VanceVagell/kv4p-ht/pcb/filter-test-boards/MiniCircuits-LTCC/MiniCircuits-LTCC.kicad_pcb

## KiCad design pcb/filter-test-boards/MiniCircuits-LTCC/MiniCircuits-LTCC.kicad_pcb (2025-03-26)

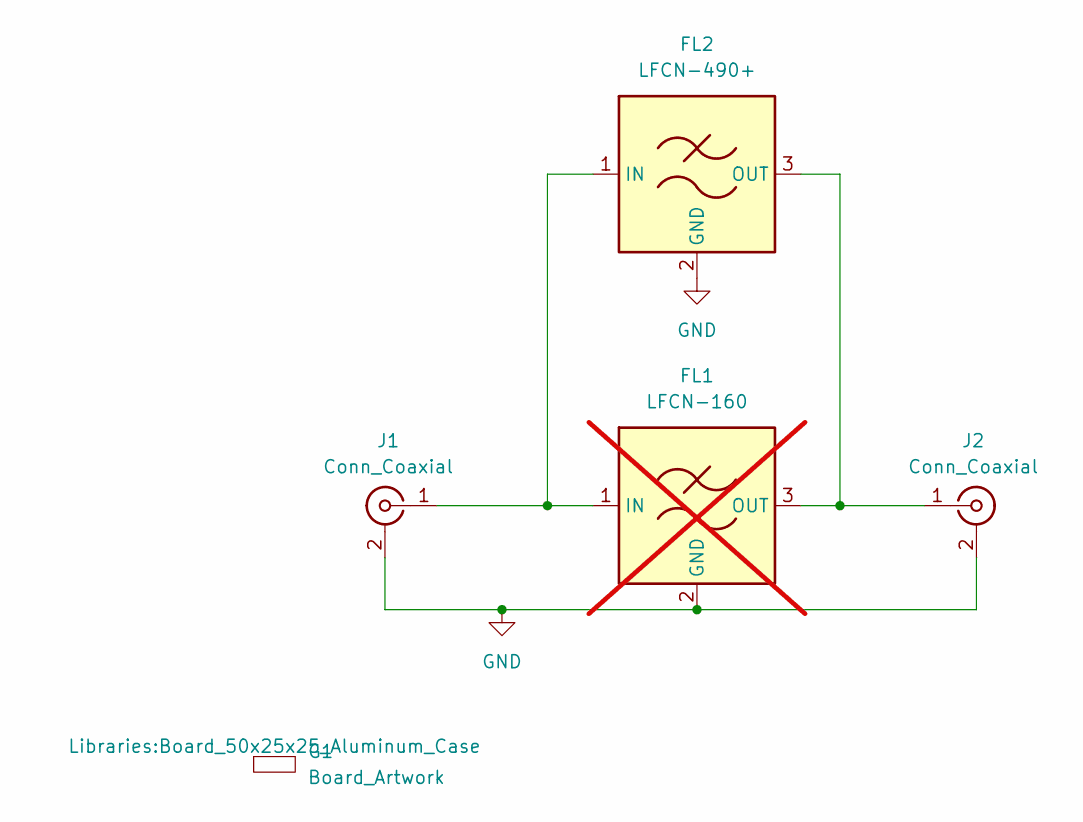
[picture p2: schematic MiniCircuits-LTCC.kicad_sch]

Parts:
FL1: LFCN-160; Filter_Mini-Circuits_FV1206; LCSC C879890; not fitted
FL2: LFCN-490+; Filter_Mini-Circuits_FV1206; LCSC C5333288
G1: Board_Artwork; Board_50x25x25_Aluminum_Case
J1, J2: Conn_Coaxial; Conn_BNC_Midplane_Amphenol_112640

Connections:
GND: FL1.2 (GND), FL1.4 (GND), FL2.2 (GND), FL2.4 (GND), J1.2 (Ext), J2.2 (Ext)
unnamed: FL1.1 (IN), FL2.1 (IN), J1.1 (In)
unnamed: FL1.3 (OUT), FL2.3 (OUT), J2.1 (In)

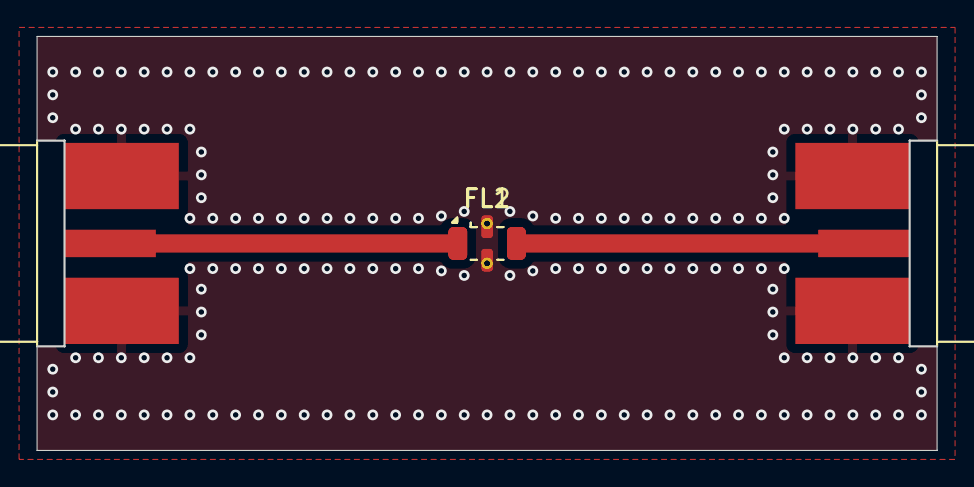
[picture p3: board MiniCircuits-LTCC.kicad_pcb from above]

Board: 2 copper layers, 50.0 x 23.0 mm, 5 parts (0 on the bottom side), 3 nets.
